Lelk0e/DA_Sensorbox/README.md

# DA_Sensorbox
Partnerfirma: b2-electronics
Teammitglieder: Mayer Phillip, Yilmaz Mert-Can, Schatzmann Alexander, Marte Linus
Software: Clockify, Github
