Lelk0e/DA_Sensorbox/Website/readme.txt

This website shows sensor data with the help of a graph. 
The graph can be filtered trough the comboboxes and then be applied trough the apply button. 

The guy, who made the whole programming in this website, is me, Mert, follow me on https://github.com 
under the name God (Mcy61).
