Lelk0e/DA_Sensorbox/Ilustrations/Mesh_Topologie.png

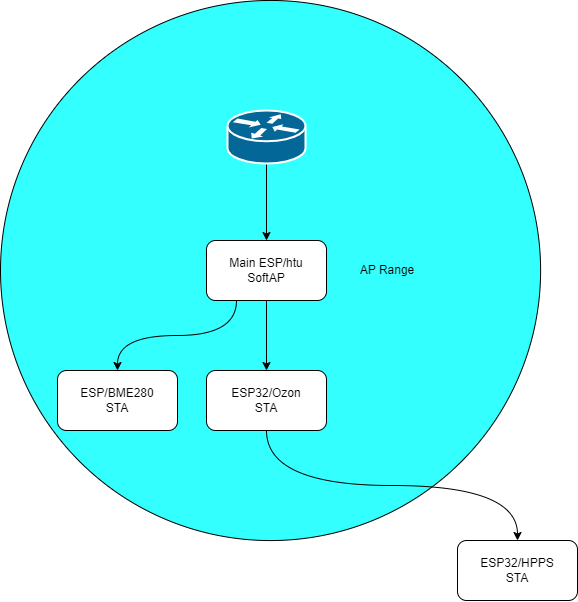
Ilustrations/Mesh_Topologie.png
