Lelk0e/DA_Sensorbox/Sensorbox_HW/Partlist/V2_Partlist_for_7_2_2025.xlsx

HW-SENSORBOX
Bauteilnamen | Werte | Datasheet | Footprint | Anzahl für 1 Sensorbox | Anzahl für 4 Sensorboxen | Bestellnummer | Besteller | Link
ADC1,GND1,SCL1,SDA/Signal1,VCC1 | Conn_01x01_Socket | ~ | Connector_PinHeader_2.00mm:PinHeader_1x01_P2.00mm_Vertical | 5 | 10 | BCS-105-L-S-TE | Mouser | https://www.mouser.at/ProductDetail/Samtec/BCS-105-L-S-TE?qs=0lQeLiL1qyaMkEiX4cl9NA%3D%3D
BT1 | BC3AAAPC |  | Battery_Basket:BatteryHolder_Keystone_2479_3xAAA | 1 | 10 | BC4AAAPC-ND | Digikey | https://www.digikey.com/en/products/detail/mpd-memory-protection-devices/bc4aaapc/2439255
C1,C2,C3,C4,C5,C7,C8,C9,C10,C11,C12,C13,CO4 | 100nF-50V | ~ | Capacitor_SMD:C_1206_3216Metric_Pad1.33x1.80mm_HandSolder | 13 | 130 | VJ1206Y104JXAAT | Mouser | https://www.mouser.at/ProductDetail/Vishay-Vitramon/VJ1206Y104JXAAT
C14 - GEPOLT | 100uF - 16V | ~ | Capacitor_SMD:CP_Elec_6.3x7.7 | 1 | 10 | AVS107M16E16T-F | Mouser | https://www.mouser.at/ProductDetail/Cornell-Dubilier-CDE/AVS107M16E16T-F?qs=7mAFCb0QvLHWeBEUpi7LdA%3D%3D
CO1,CO2 | 33uF - 16V | ~ | Capacitor_SMD:C_1812_4532Metric_Pad1.57x3.40mm_HandSolder | 2 | 20 | C4532X5R1C336M250KA | Mouser | https://www.mouser.at/ProductDetail/TDK/C4532X5R1C336M250KA
CR1220 | Battery | ~ | Battery:BatteryHolder_LINX_BAT-HLD-012-SMT | 1 | 10 | BAT-HLD-012-SMT | Mouser | https://eu.mouser.com/ProductDetail/TE-Connectivity-Linx-Technologies/BAT-HLD-012-SMT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
CT1 | 1500pF - 50V | ~ | Capacitor_SMD:C_1206_3216Metric_Pad1.33x1.80mm_HandSolder | 1 | 10 | VJ1206A152JXAMT | Mouser | https://www.mouser.at/ProductDetail/Vishay-Vitramon/VJ1206A152JXAMT?qs=yLK21R3P1nepmGezkusWog%3D%3D
D1 | 1N5819 | http://www.vishay.com/docs/88525/1n5817.pdf | Diode_SMD:D_SMB-SMC_Universal_Handsoldering | 1 | 10 | 1N5819HW-7-F | Mouser | https://www.mouser.at/ProductDetail/Diodes-Incorporated/1N5819HW-7-F?qs=NQ47qNm99eDyWTEd07miYA%3D%3D
D2,D4,D5,D7 | PESD3V3U1UA | https://www.vishay.com/docs/85751/1n4148ws.pdf | Diode_SMD:D_SOD-323 | 4 | 40 | PESD3V3U1UA,115 | Mouser | https://www.mouser.at/ProductDetail/Nexperia/PESD3V3U1UA115?qs=LOCUfHb8d9um8sDoel6KgQ%3D%3D
D3 | SMBJ5.0A | https://www.vishay.com/docs/88301/15ke.pdf | Diode_SMD:D_SMB_Handsoldering | 1 | 10 | SMBJ5.0A-E3/52 | Mouser | https://www.mouser.at/ProductDetail/Vishay-General-Semiconductor/SMBJ5.0A-E3-52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
F1 | Polyfuse_Small | ~ | Fuse:Fuse_Littelfuse_372_D8.50mm | 1 | 10 | LVR016K | Mouser | https://www.mouser.at/ProductDetail/Littelfuse/LVR016K?qs=sGAEpiMZZMt8Ji9PfVTQzN6NT3KHR8M0Bcdq0wgyxVc%3D
JP1 | Jumper_2_Bridged | ~ | Connector_PinHeader_2.54mm:PinHeader_1x02_P2.54mm_Vertical | 1 | 10 | 61300211121 | Mouser | https://www.mouser.at/ProductDetail/Wurth-Elektronik/61300211121?qs=t4813l51qx%252B1A5GYDQxPlw%3D%3D
L1 | 56ÂµH - 2.1A | ~ | Inductor_SMD:L_0805_2012Metric_Pad1.05x1.20mm_HandSolder | 1 | 10 | 744771156 | Mouser | https://www.mouser.at/ProductDetail/Wurth-Elektronik/744771156?qs=E%2F%2FhvbtCqpMc%2F29JH%252BKd8Q%3D%3D
MicroSD2,U7 | ~ |  | -- mixed values -- | 2 | 10 | 104031-0811 | Mouser | https://www.mouser.at/ProductDetail/Molex/104031-0811?qs=udsGRKD4nA3Tvy7wqky%252BuA%3D%3D
R1 | 10R | ~ | Resistor_SMD:R_1206_3216Metric_Pad1.30x1.75mm_HandSolder | 1 | 10 | TNPW120610R0BEEA | Mouser | https://www.mouser.at/ProductDetail/Vishay-Dale/TNPW120610R0BEEA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
R1_1,Rset1 | 10k | ~ | Resistor_SMD:R_1206_3216Metric_Pad1.30x1.75mm_HandSolder | 2 | 20 | RT1206FRE1310KL | Mouser | https://www.mouser.at/ProductDetail/YAGEO/RT1206FRE1310KL?qs=Fz%2FrpjPuTcG5N6QupHrVzw%3D%3D
R1_2 | 0R | ~ | Resistor_SMD:R_1206_3216Metric_Pad1.30x1.75mm_HandSolder | 1 | 10 | MCA12060Z0000ZP500 | Mouser | https://www.mouser.at/ProductDetail/Vishay-Beyschlag/MCA12060Z0000ZP500
R1_3 | 1.3 kR | ~ | Resistor_SMD:R_1206_3216Metric_Pad1.30x1.75mm_HandSolder | 1 | 10 | CRCW12061K30FKEAHP | Mouser | https://www.mouser.at/ProductDetail/Vishay-Dale/CRCW12061K30FKEAHP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
R1_4,R1_5 | 1kR | ~ | Resistor_SMD:R_1206_3216Metric_Pad1.30x1.75mm_HandSolder | 2 | 20 | ERA-8AEB102V | Mouser | https://www.mouser.at/ProductDetail/Panasonic/ERA-8AEB102V
R1_6,R2,R9,R10,R18,R19 | 10kR | ~ | Resistor_SMD:R_1206_3216Metric_Pad1.30x1.75mm_HandSolder | 6 | 60 | ERA-8VRB1002V | Mouser | https://www.mouser.at/ProductDetail/Panasonic/ERA-8VRB1002V
R1_7 | 2k2 | ~ | Resistor_SMD:R_1206_3216Metric_Pad1.30x1.75mm_HandSolder | 1 | 10 | ERJ-T08J222V | Mouser | https://www.mouser.at/ProductDetail/Panasonic/ERJ-T08J222V?qs=sGAEpiMZZMvdGkrng054tzSGWtpoOZZITsjqBumh3fU%3D
R2_1 | 6k8 | ~ | Resistor_SMD:R_1206_3216Metric_Pad1.30x1.75mm_HandSolder | 1 | 10 | MCA12060D6801BP500 | Mouser | https://www.mouser.at/ProductDetail/Vishay-Beyschlag/MCA12060D6801BP500
R3,R4 | 100R | ~ | Resistor_SMD:R_1206_3216Metric_Pad1.30x1.75mm_HandSolder | 2 | 20 | RT1206FRE13100RL | Mouser | https://www.mouser.at/ProductDetail/YAGEO/RT1206FRE13100RL?qs=1mbolxNpo8fXWimun2XthA%3D%3D
R5,R7,R8,R15 | 4.7k | ~ | Resistor_SMD:R_1206_3216Metric_Pad1.30x1.75mm_HandSolder | 4 | 40 | RT1206FRE074K7L | Mouser | https://www.mouser.at/ProductDetail/YAGEO/RT1206FRE074K7L?qs=yNCrj0CQcyLcoH%2FB%252BiP%2FFQ%3D%3D
R6 | 20kR | ~ | Resistor_SMD:R_1206_3216Metric_Pad1.30x1.75mm_HandSolder | 1 | 10 | ERA-8APB203V | Mouser | https://www.mouser.at/ProductDetail/Panasonic/ERA-8APB203V
R20,R21,R33 | 3k | ~ | Resistor_SMD:R_1206_3216Metric_Pad1.30x1.75mm_HandSolder | 3 | 30 | RT1206FRE073KL | Mouser | https://www.mouser.at/ProductDetail/YAGEO/RT1206FRE073KL?qs=yNCrj0CQcyKT5hyFvM%2FxIg%3D%3D
Rsc1 | 0R39 | ~ | Resistor_SMD:R_1206_3216Metric_Pad1.30x1.75mm_HandSolder | 1 | 10 | RCWE1206R390FKEA | Mouser | https://www.mouser.at/ProductDetail/Vishay-Dale/RCWE1206R390FKEA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
Rx1 | 180R | ~ | Resistor_SMD:R_1206_3216Metric_Pad1.30x1.75mm_HandSolder | 1 | 10 | TNPW1206180RBEEA | Mouser | https://www.mouser.at/ProductDetail/Vishay-Dale/TNPW1206180RBEEA
TH2 | Type K | https://www.heraeus.com/media/media/group/doc_group/products_1/hst/sot_to/de_15/to_92_d.pdf | Resistor_THT:R_Axial_DIN0204_L3.6mm_D1.6mm_P5.08mm_Horizontal | 0 | 0 | Type K, PTFE, 1m | x | x
TP1,TP2,TP3,TP4,TP5,TP6,TP7,TP10,TP11 | TestPoint | ~ | TestPoint:TestPoint_Loop_D1.80mm_Drill1.0mm_Beaded | 9 | 100 | SMC-1-01-1-GT | Digikey | https://www.digikey.com/en/products/detail/adam-tech/SMC-1-01-1-GT/9830404
U1 | BME280 | https://www.bosch-sensortec.com/media/boschsensortec/downloads/datasheets/bst-bme280-ds002.pdf | BME280 (2):BME280 | 0 | 0 | x | x | x
U2,U5,U13 | OPA197xD | http://www.ti.com/lit/ds/symlink/opa197.pdf | Package_SO:SOIC-8_3.9x4.9mm_P1.27mm | 3 | 30 | OPA197IDR | Mouser | https://www.mouser.at/ProductDetail/Texas-Instruments/OPA197IDR?qs=gMfM3zrbS4ovW9KDi3YhFw%3D%3D
U4 | MC33063AD | http://www.onsemi.com/pub_link/Collateral/MC34063A-D.PDF | Package_SO:SOIC-8_3.9x4.9mm_P1.27mm | 0 | 0 | x | x | x
U6 | MAX31855EASA | http://datasheets.maximintegrated.com/en/ds/MAX31855.pdf | Package_SO:SOIC-8_3.9x4.9mm_P1.27mm | 1 | 10 | MAX31855EASA+ | Mouser | https://www.mouser.at/ProductDetail/Analog-Devices-Maxim-Integrated/MAX31855EASA%2b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
U8 | HPP845E131R5 | HPP845E131R5 | HPP_footprints:SON6_HPP845E131R5_TEC | 0 | 0 | x | x | x
U11 | PS1-O3-100 | https://sgx.cdistore.com/datasheets/sgx/ds-0353-ps1ps4-o3-100.pdf | Ozonsensor:PS1O3100 | 0 | 0 | x | x | x
U12 | DS3231M | http://datasheets.maximintegrated.com/en/ds/DS3231.pdf | Package_SO:SOIC-16W_7.5x10.3mm_P1.27mm | 1 | 10 | DS3231M+ | Mouser | https://www.mouser.at/ProductDetail/Analog-Devices-Maxim-Integrated/DS3231M%2b?qs=Bakm8ERcljpd4MQpcnSykw%3D%3D
Jumper | x | x | x | 1 | 10 | M7686-05 | Mouser | https://www.mouser.at/ProductDetail/Harwin/M7686-05?qs=%252Bk6%2F5FB6qrn2j2nK8fZfOA%3D%3D
2x 19pin für esp | x | x | x | 2 | 20 | SSW-119-01-T-S | Mouser | https://www.mouser.at/ProductDetail/Samtec/SSW-119-01-T-S?qs=rU5fayqh%252BE1O7STzIZWpjA%3D%3D
5pin Stecker ex.Sensor | x | x | x | 1 | 10 | 61300511121 | Mouser | https://www.mouser.at/ProductDetail/Wurth-Elektronik/61300511121?qs=PhR8RmCirEZCsCRHq%252BvfRQ%3D%3D
2 pin Socket (für TypK-Sensor) | x | x | x | 1 | 10 | SMC-1-02-1-GT | Mouser | https://www.mouser.at/ProductDetail/Adam-Tech/SMC-1-02-1-GT?qs=HoCaDK9Nz5fkB9er4tyTzQ%3D%3D
CR1220 Batterie | x | https://www.mouser.at/datasheet/2/575/1/2684410000_BATTERY_CR1220_3V_en-3038809.pdf | x | 1 | 10 | 2684410000 | Mouser | https://www.mouser.at/ProductDetail/Weidmuller/2684410000?qs=QNEnbhJQKvb766Vpshc03A%3D%3D
