Lelk0e/DA_Sensorbox/docs/Zitate/How to Set an ESP32 Access Point (AP) for Web Server.md

https://randomnerdtutorials.com/esp32-access-point-ap-web-server/
--- 
creation date: 2024-09-30 16:28 
modification date: Monday 30th September 2024 16:28:57 
 << [[2024-09-29]] | [[2024-10-01]] >>
 ___
