Lelk0e/DA_Sensorbox/Website/bme_test_data.txt

Time:11:30:08:BME:-6.16
Time:11:30:38:BME:31.97
Time:11:31:08:BME:9.05
Time:11:31:38:BME:1.56
Time:11:32:08:BME:13.92
Time:11:32:38:BME:37.68
Time:11:33:08:BME:33.69
Time:11:33:38:BME:24.49
Time:11:34:08:BME:31.39
Time:11:34:38:BME:25.84
Time:11:35:08:BME:15.9
Time:11:35:38:BME:-8.05
Time:11:36:08:BME:0.58
Time:11:36:38:BME:29.17
Time:11:37:08:BME:39.38
Time:11:37:38:BME:13.2
Time:11:38:08:BME:22.78
Time:11:38:38:BME:-0.13
Time:11:39:08:BME:36.73
Time:11:39:38:BME:-0.84
Time:11:40:08:BME:11.67
Time:11:40:38:BME:38.87
Time:11:41:08:BME:28.73
Time:11:41:38:BME:38.58
Time:11:42:08:BME:-8.95
Time:11:42:38:BME:10.34
Time:11:43:08:BME:29.47
Time:11:43:38:BME:-2.81
Time:11:44:08:BME:22.15
Time:11:44:38:BME:25.21
Time:11:45:08:BME:7.74
Time:11:45:38:BME:16.08
Time:11:46:08:BME:-5.23
Time:11:46:38:BME:17.41
Time:11:47:08:BME:-3.66
Time:11:47:38:BME:34.61
Time:11:48:08:BME:18.48
Time:11:48:38:BME:-6.05
Time:11:49:08:BME:35.43
Time:11:49:38:BME:38.44
Time:11:50:08:BME:-1.57
Time:11:50:38:BME:19.93
Time:11:51:08:BME:20.14
Time:11:51:38:BME:-6.56
Time:11:52:08:BME:8.47
Time:11:52:38:BME:36.72
Time:11:53:08:BME:20.53
Time:11:53:38:BME:4.05
Time:11:54:08:BME:20.84
Time:11:54:38:BME:29.05
Time:11:55:08:BME:24.32
Time:11:55:38:BME:28.73
Time:11:56:08:BME:24.08
Time:11:56:38:BME:21.16
Time:11:57:08:BME:36.69
Time:11:57:38:BME:25.4
Time:11:58:08:BME:25.52
Time:11:58:38:BME:6.03
Time:11:59:08:BME:29.75
Time:11:59:38:BME:-3.06
Time:12:00:08:BME:19.16
Time:12:00:38:BME:16.07
Time:12:01:08:BME:14.53
Time:12:01:38:BME:24.58
Time:12:02:08:BME:-0.37
Time:12:02:38:BME:6.06
Time:12:03:08:BME:-3.31
Time:12:03:38:BME:4.62
Time:12:04:08:BME:-9.67
Time:12:04:38:BME:6.13
Time:12:05:08:BME:21.29
Time:12:05:38:BME:16.16
Time:12:06:08:BME:8.46
Time:12:06:38:BME:-1.27
Time:12:07:08:BME:10.0
Time:12:07:38:BME:-5.95
Time:12:08:08:BME:18.73
Time:12:08:38:BME:17.48
Time:12:09:08:BME:5.92
Time:12:09:38:BME:30.12
Time:12:10:08:BME:16.74
Time:12:10:38:BME:39.02
Time:12:11:08:BME:11.24
Time:12:11:38:BME:-3.48
Time:12:12:08:BME:19.44
Time:12:12:38:BME:35.31
Time:12:13:08:BME:13.81
Time:12:13:38:BME:10.18
Time:12:14:08:BME:28.26
Time:12:14:38:BME:17.36
Time:12:15:08:BME:2.21
Time:12:15:38:BME:12.95
Time:12:16:08:BME:30.81
Time:12:16:38:BME:-1.07
Time:12:17:08:BME:39.37
Time:12:17:38:BME:25.26
Time:12:18:08:BME:-9.11
Time:12:18:38:BME:-8.35
Time:12:19:08:BME:6.93
Time:12:19:38:BME:25.79
