Lelk0e/DA_Sensorbox/Sensorbox_HW/SensorBox/SensorBox.kicad_pcb

## KiCad design Sensorbox_HW/SensorBox/SensorBox.kicad_pcb (2025-06-12)

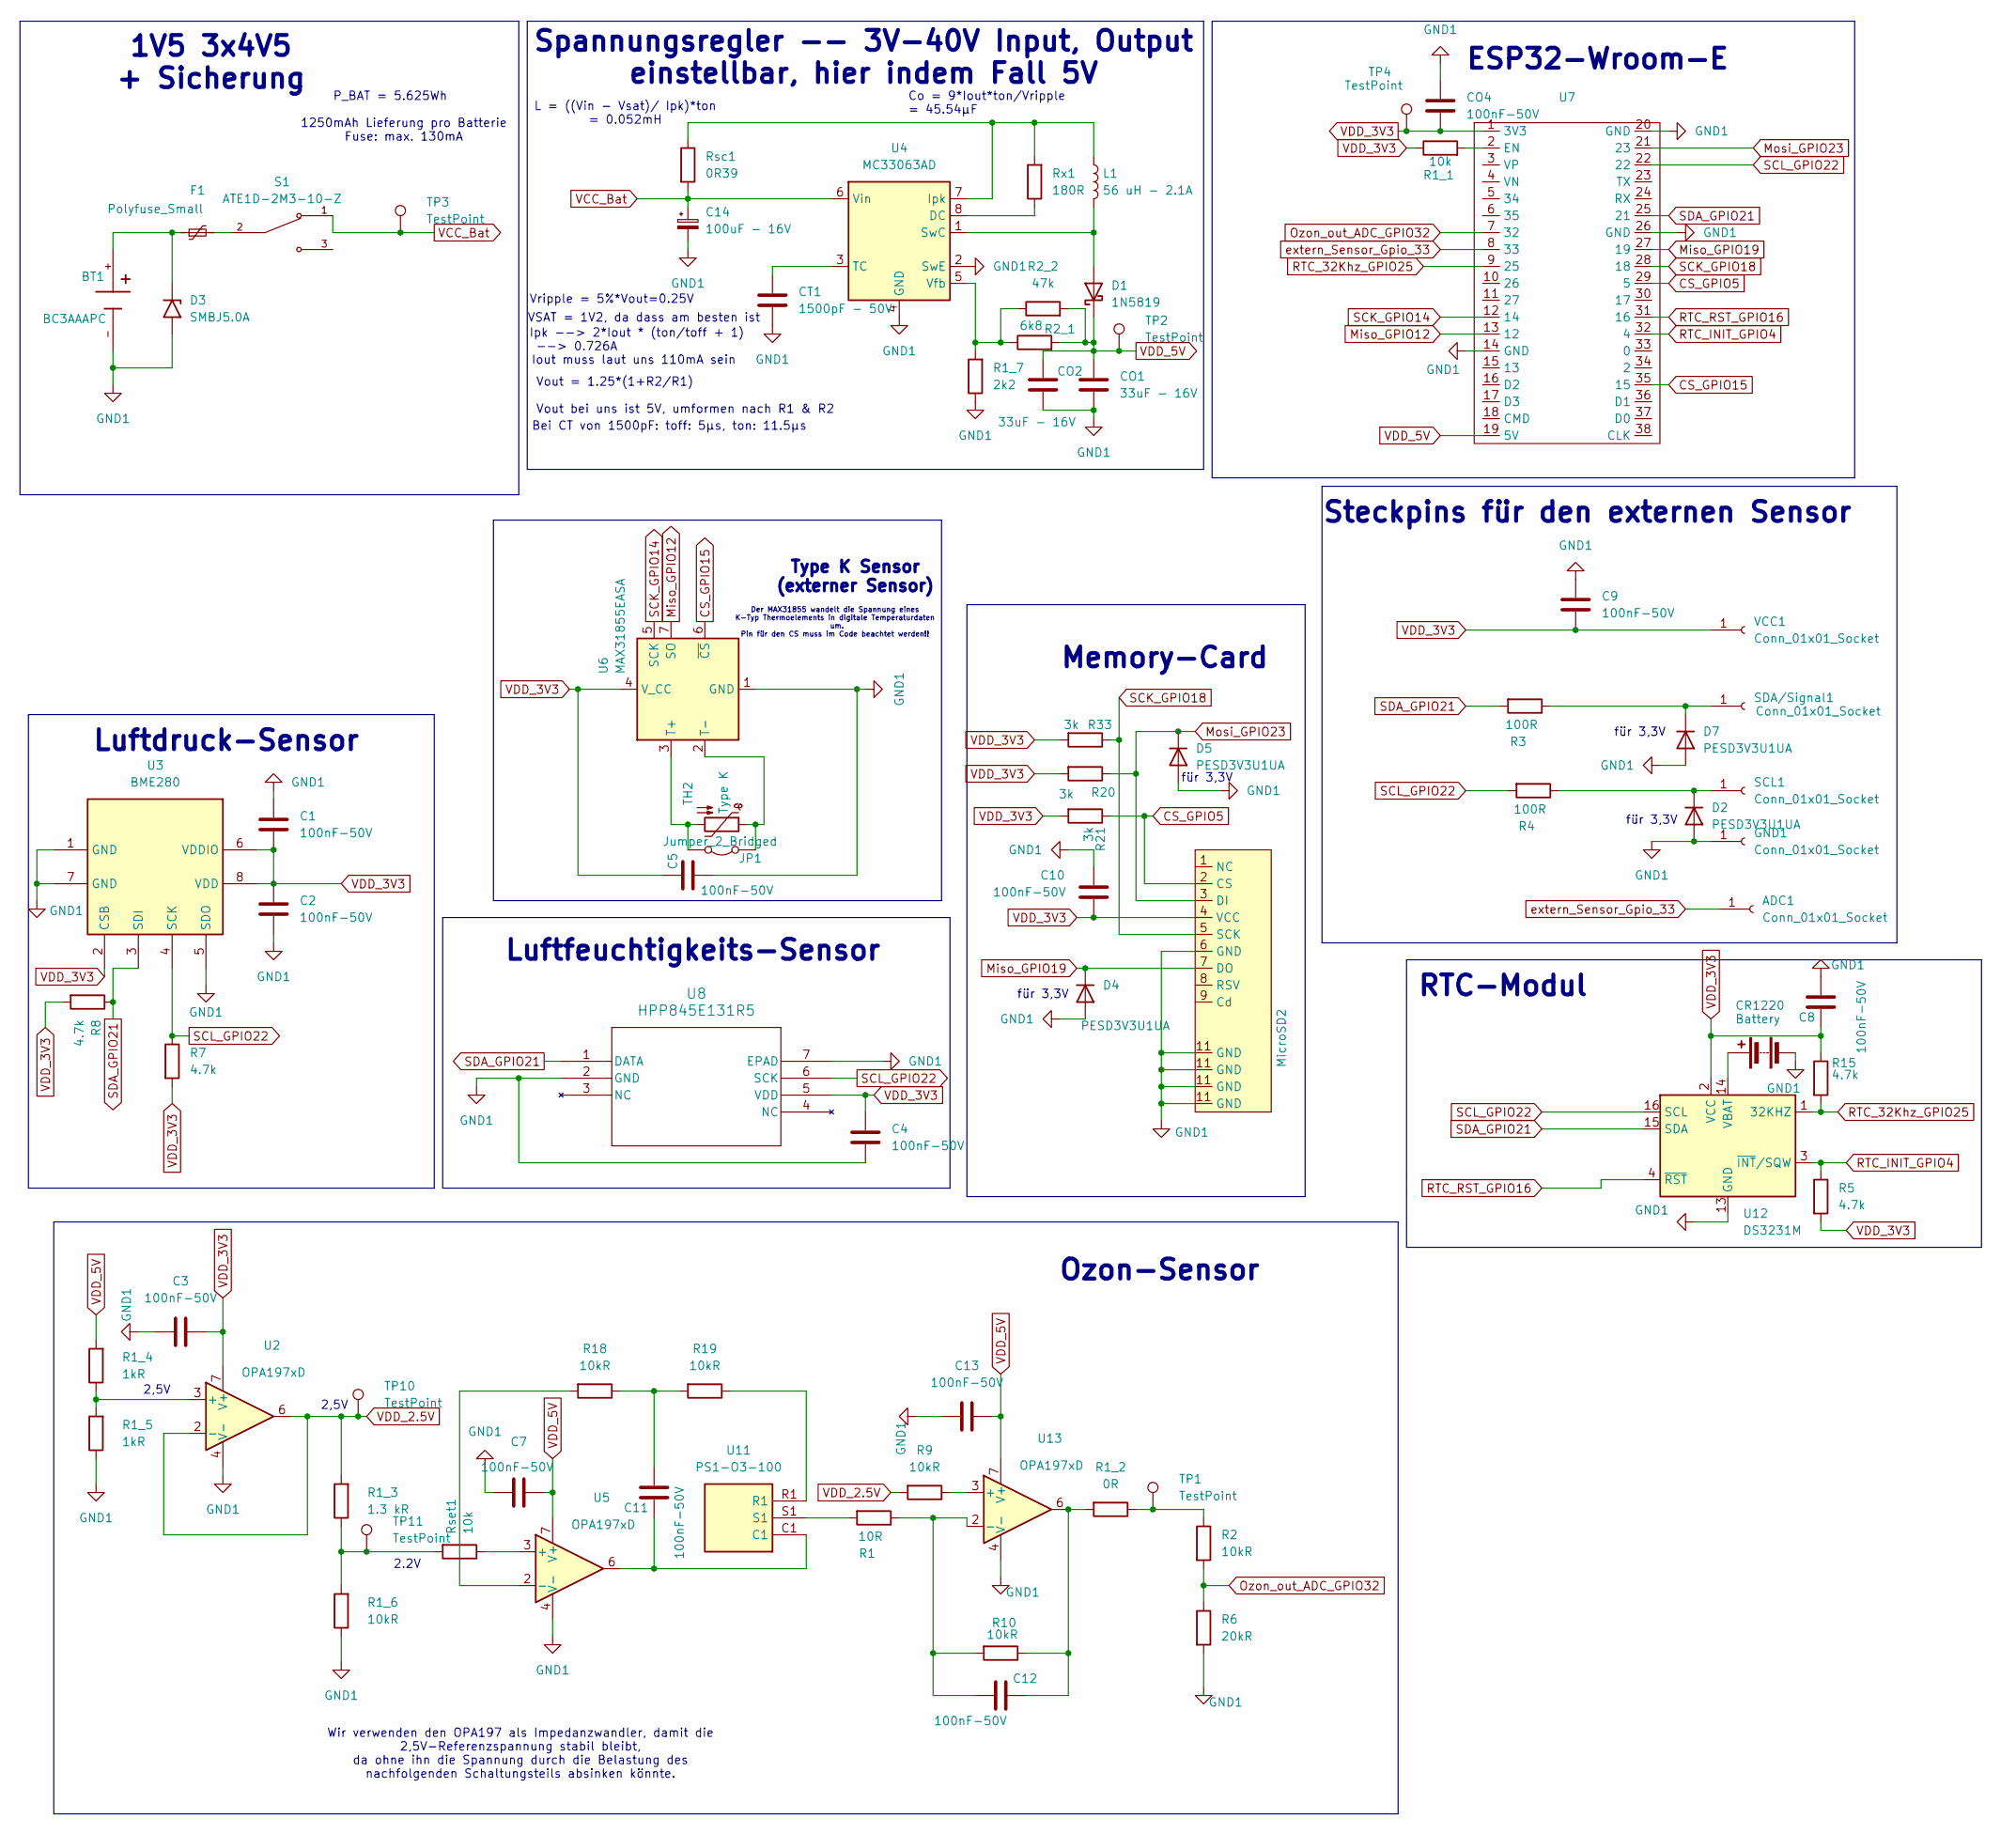
[picture p43: schematic SensorBox.kicad_sch]

Parts:
ADC1: Conn_01x01_Socket; PinHeader_1x01_P2.00mm_Vertical
BT1: BC3AAAPC; BatteryHolder_Keystone_2479_3xAAA; PARTREV J
C1, C2, C3, C4, C5, C7, C8, C9, C10, C11, C12, C13: 100nF-50V; C_1206_3216Metric_Pad1.33x1.80mm_HandSolder
C14: 100uF - 16V; CP_Elec_6.3x7.7
CO1, CO2: 33uF - 16V; C_1812_4532Metric_Pad1.57x3.40mm_HandSolder
CO4: 100nF-50V; C_1206_3216Metric_Pad1.33x1.80mm_HandSolder
CR1220: Battery; BatteryHolder_LINX_BAT-HLD-012-SMT
CT1: 1500pF - 50V; C_1206_3216Metric_Pad1.33x1.80mm_HandSolder
D1: 1N5819; D_SMB-SMC_Universal_Handsoldering
D2, D4, D5, D7: PESD3V3U1UA; D_SOD-323
D3: SMBJ5.0A; D_SMB_Handsoldering
F1: Polyfuse_Small; Fuse_Littelfuse_372_D8.50mm
GND1: Conn_01x01_Socket; PinHeader_1x01_P2.00mm_Vertical
JP1: Jumper_2_Bridged; PinHeader_1x02_P2.54mm_Vertical
L1: 56 uH - 2.1A; L1
MicroSD2: microSD_HC_Molex_104031-0811
R1: 10R; R_1206_3216Metric_Pad1.30x1.75mm_HandSolder
R1_1: 10k; R_1206_3216Metric_Pad1.30x1.75mm_HandSolder
R1_2: 0R; R_1206_3216Metric_Pad1.30x1.75mm_HandSolder
R1_3: 1.3 kR; R_1206_3216Metric_Pad1.30x1.75mm_HandSolder
R1_4, R1_5: 1kR; R_1206_3216Metric_Pad1.30x1.75mm_HandSolder
R1_6, R2, R9, R10, R18, R19: 10kR; R_1206_3216Metric_Pad1.30x1.75mm_HandSolder
R1_7: 2k2; R_1206_3216Metric_Pad1.30x1.75mm_HandSolder
R2_1: 6k8; R_1206_3216Metric_Pad1.30x1.75mm_HandSolder
R2_2: 47k; R_1206_3216Metric_Pad1.30x1.75mm_HandSolder
R3, R4: 100R; R_1206_3216Metric_Pad1.30x1.75mm_HandSolder
R5, R7, R8, R15: 4.7k; R_1206_3216Metric_Pad1.30x1.75mm_HandSolder
R6: 20kR; R_1206_3216Metric_Pad1.30x1.75mm_HandSolder
R20, R21, R33: 3k; R_1206_3216Metric_Pad1.30x1.75mm_HandSolder
Rsc1: 0R39; R_1206_3216Metric_Pad1.30x1.75mm_HandSolder
Rset1: 10k; R_1206_3216Metric_Pad1.30x1.75mm_HandSolder
Rx1: 180R; R_1206_3216Metric_Pad1.30x1.75mm_HandSolder
S1: ATE1D-2M3-10-Z; SW_ATE1D-2M3-10-Z
SCL1: Conn_01x01_Socket; PinHeader_1x01_P2.00mm_Vertical
SDA/Signal1: Conn_01x01_Socket; PinHeader_1x01_P2.00mm_Vertical
TH2: Type K; R_Axial_DIN0204_L3.6mm_D1.6mm_P5.08mm_Horizontal
TP1, TP2, TP3, TP4, TP10, TP11: TestPoint; TestPoint_Loop_D1.80mm_Drill1.0mm_Beaded
U2, U5, U13: OPA197xD; SOIC-8_3.9x4.9mm_P1.27mm
U3: BME280; Bosch_LGA-8_2.5x2.5mm_P0.65mm_ClockwisePinNumbering_ch
U4: MC33063AD; SOIC-8_3.9x4.9mm_P1.27mm
U6: MAX31855EASA; SOIC-8_3.9x4.9mm_P1.27mm
U7: ESP32_Wroom_E
U8: HPP845E131R5; SON6_HPP845E131R5_TEC
U11: PS1-O3-100; PS1O3100; Manufacturer_Part_Number PS1-O3-100
U12: DS3231M; SOIC-16W_7.5x10.3mm_P1.27mm
VCC1: Conn_01x01_Socket; PinHeader_1x01_P2.00mm_Vertical

Connections:
CS_GPIO5: MicroSD2.2 (CS), R21.1, U7.29 (5)
CS_GPIO15: U6.6 (~CS), U7.35 (15)
GND1: BT1.-, C1.1, C2.1, C3.2, C4.2, C5.2, C7.2, C8.2, C9.2, C10.2, C13.2, C14.2, CO1.2, CO2.2, CO4.1, CR1220.2 (-), CT1.2, D2.2 (A), D3.2 (A2), D4.2 (A), D5.2 (A), D7.2 (A), GND1.1, MicroSD2.6 (GND), MicroSD2.11 (GND), R1_5.1, R1_6.1, R1_7.1, R6.2, U2.4 (V-), U3.1 (GND), U3.5 (SDO), U3.7 (GND), U4.2 (SwE), U4.4 (GND), U5.4 (V-), U6.1 (GND), U7.14 (GND), U7.20 (GND), U7.26 (GND), U8.2 (GND), U8.7 (EPAD), U12.5 (GND), U12.6 (GND), U12.7 (GND), U12.8 (GND), U12.9 (GND), U12.10 (GND), U12.11 (GND), U12.12 (GND), U12.13 (GND), U13.4 (V-)
Miso_GPIO12: U6.7 (SO), U7.13 (12)
Miso_GPIO19: D4.1 (K), MicroSD2.7 (DO), U7.27 (19)
Mosi_GPIO23: D5.1 (K), MicroSD2.3 (DI), R20.1, U7.21 (23)
unnamed: C11.1, U5.6, U11.C1
unnamed: C11.2, R18.1, R19.2
unnamed: C12.2, R1_2.2, R10.1, U13.6
unnamed: CR1220.1 (+), U12.14 (VBAT)
unnamed: D1.2 (A), L1.2, U4.1 (SwC)
unnamed: D2.1 (K), R4.1, SCL1.1
unnamed: BT1.+, D3.1 (A1), F1.1
unnamed: D7.1 (K), R3.1, SDA/Signal1.1
unnamed: F1.2, S1.2
unnamed: JP1.1 (A), TH2.1, U6.2 (T-)
unnamed: JP1.2 (B), TH2.2, U6.3 (T+)
unnamed: R1.2, U11.S1
unnamed: R1_2.1, R2.1, TP1.1
unnamed: R1_3.1, R1_6.2, Rset1.2, TP11.1
unnamed: R19.1, U11.R1
unnamed: R1_4.1, R1_5.2, U2.3 (+)
unnamed: Rx1.1, U4.8 (DC)
unnamed: L1.1, Rsc1.1, Rx1.2, U4.7 (Ipk)
unnamed: CT1.1, U4.3 (TC)
unnamed: R1_7.2, R2_1.1, R2_2.1, U4.5 (Vfb)
unnamed: Rset1.1, U5.3 (+)
unnamed: R18.2, U5.2 (-)
unnamed: R1_1.2, U7.2 (EN)
unnamed: R9.1, U13.3 (+)
unnamed: C12.1, R1.1, R10.2, U13.2 (-)
Ozon_out_ADC_GPIO32: R2.2, R6.1, U7.7 (32)
RTC_32Khz_GPIO25: R15.2, U7.9 (25), U12.1 (32KHZ)
RTC_INIT_GPIO4: R5.1, U7.32 (4), U12.3 (~INT/SQW)
RTC_RST_GPIO16: U7.31 (16), U12.4 (~RST)
SCK_GPIO14: U6.5 (SCK), U7.12 (14)
SCK_GPIO18: MicroSD2.5 (SCK), R33.1, U7.28 (18)
SCL_GPIO22: R4.2, R7.1, U3.4 (SCK), U7.22, U8.6 (SCK), U12.16 (SCL)
SDA_GPIO21: R3.2, R8.1, U3.3 (SDI), U7.25 (21), U8.1 (DATA), U12.15 (SDA)
VCC_Bat: C14.1, Rsc1.2, S1.1, TP3.1, U4.6 (Vin)
VDD_2.5V: R1_3.2, R9.2, TP10.1, U2.2 (-), U2.6
VDD_3V3: C1.2, C2.2, C3.1, C4.1, C5.1, C8.1, C9.1, C10.1, CO4.2, MicroSD2.4 (VCC), R1_1.1, R5.2, R7.2, R8.2, R15.1, R20.2, R21.2, R33.2, TP4.1, U2.7 (V+), U3.2 (CSB), U3.6 (VDDIO), U3.8 (VDD), U6.4 (V_CC), U7.1 (3V3), U8.5 (VDD), U12.2 (VCC), VCC1.1
VDD_5V: C7.1, C13.1, CO1.1, CO2.1, D1.1 (K), R1_4.2, R2_1.2, R2_2.2, TP2.1, U5.7 (V+), U7.19 (5V), U13.7 (V+)
extern_Sensor_Gpio_33: ADC1.1, U7.8 (33)

Notes on the sheet:
für 3,3V
Luftdruck-Sensor
Vripple = 5%*Vout=0.25V
Spannungsregler -- 3V-40V Input, Output einstellbar, hier indem Fall 5V
Luftfeuchtigkeits-Sensor
Ipk --> 2*Iout * (ton/toff + 1) --> 0.726A
Type K Sensor (externer Sensor)
Steckpins für den externen Sensor
1V5 3x4V5 + Sicherung
Memory-Card
Bei CT von 1500pF: toff: 5µs, ton: 11.5µs
Iout muss laut uns 110mA sein
ESP32-Wroom-E
Der MAX31855 wandelt die Spannung eines K-Typ Thermoelements in digitale Temperaturdaten um. Pin für den CS muss im Code beachtet werden!!
RTC-Modul
Wir verwenden den OPA197 als Impedanzwandler, damit die 2,5V-Referenzspannung stabil bleibt, da ohne ihn die Spannung durch die Belastung des nachfolgenden Schaltungsteils absinken könnte.
VSAT = 1V2, da dass am besten ist
1250mAh Lieferung pro Batterie Fuse: max. 130mA
Co = 9*Iout*ton/Vripple = 45.54µF
Vout = 1.25*(1+R2/R1) Vout bei uns ist 5V, umformen nach R1 & R2
P_BAT = 5.625Wh
L = ((Vin - Vsat)/ Ipk)*ton = 0.052mH
2,5V
Ozon-Sensor
2.2V

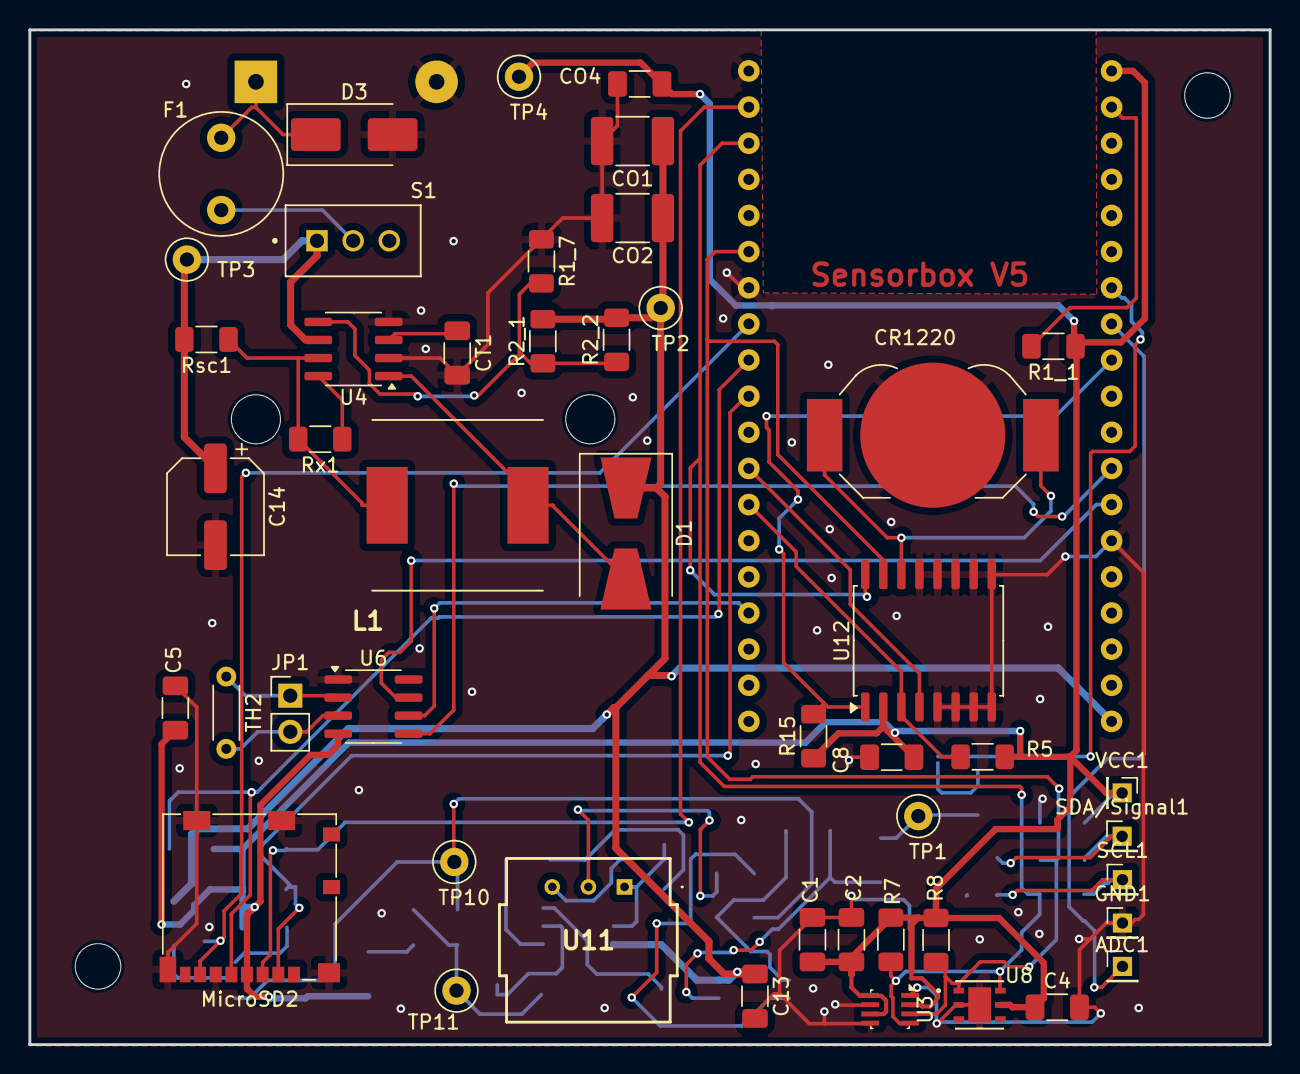
[picture p44: board SensorBox.kicad_pcb from above]

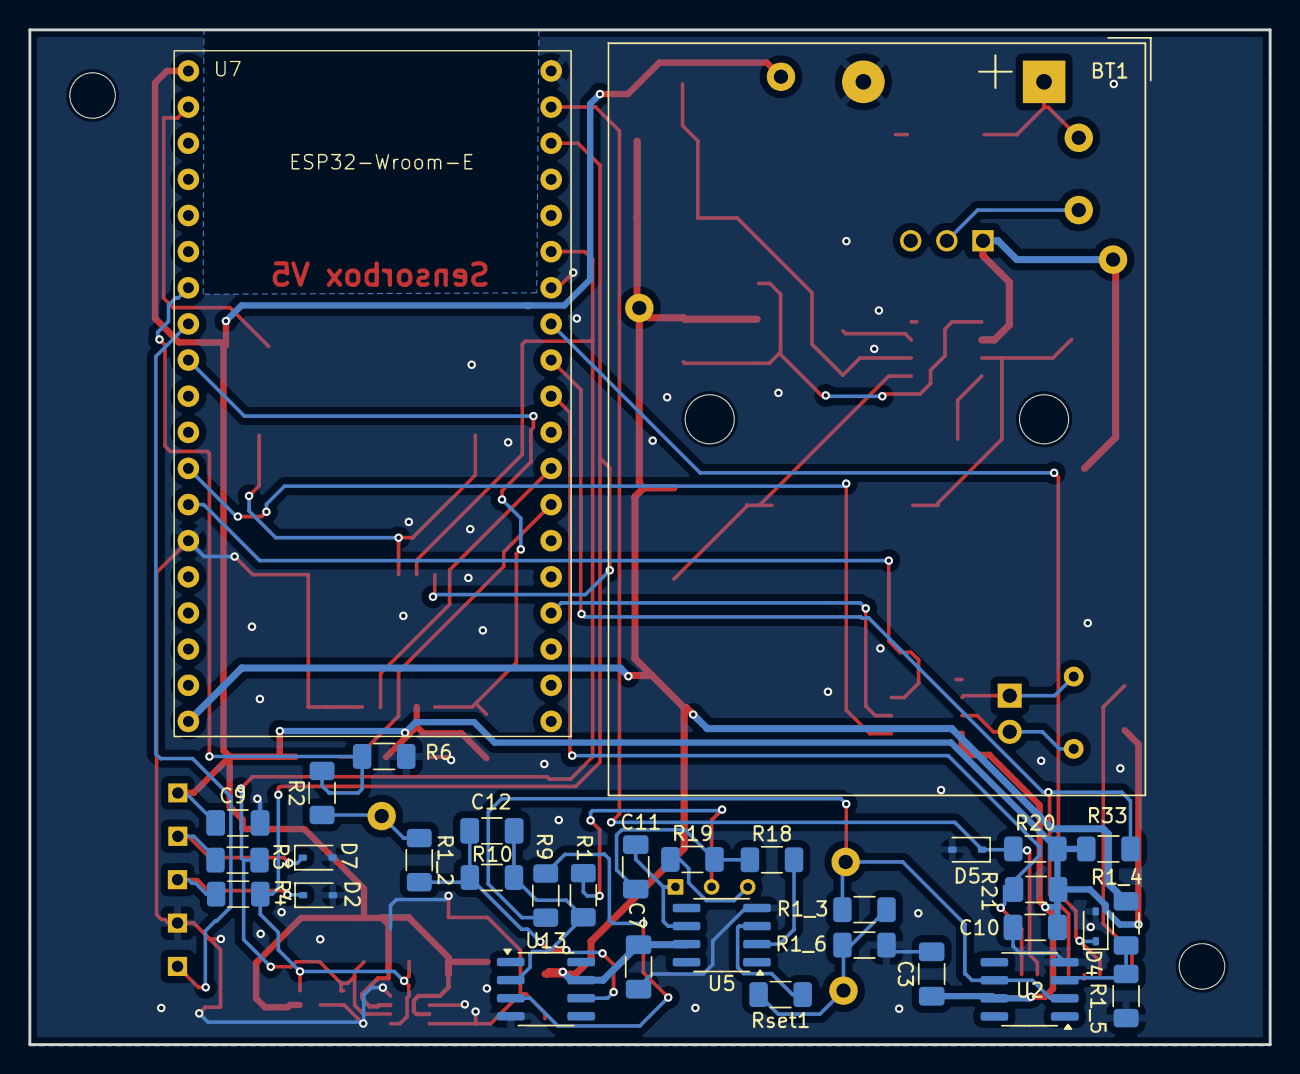
[picture p45: board SensorBox.kicad_pcb from below]

Board: 2 copper layers, 87.2 x 71.3 mm, 80 parts (33 on the bottom side), 44 nets.
