Lelk0e/DA_Sensorbox/Sensorbox_HW/Versionen/V2_16_12_2024/SensorBox/SensorBox.kicad_sch

## KiCad design Sensorbox_HW/Versionen/V2_16_12_2024/SensorBox/SensorBox.kicad_sch (2025-03-31)

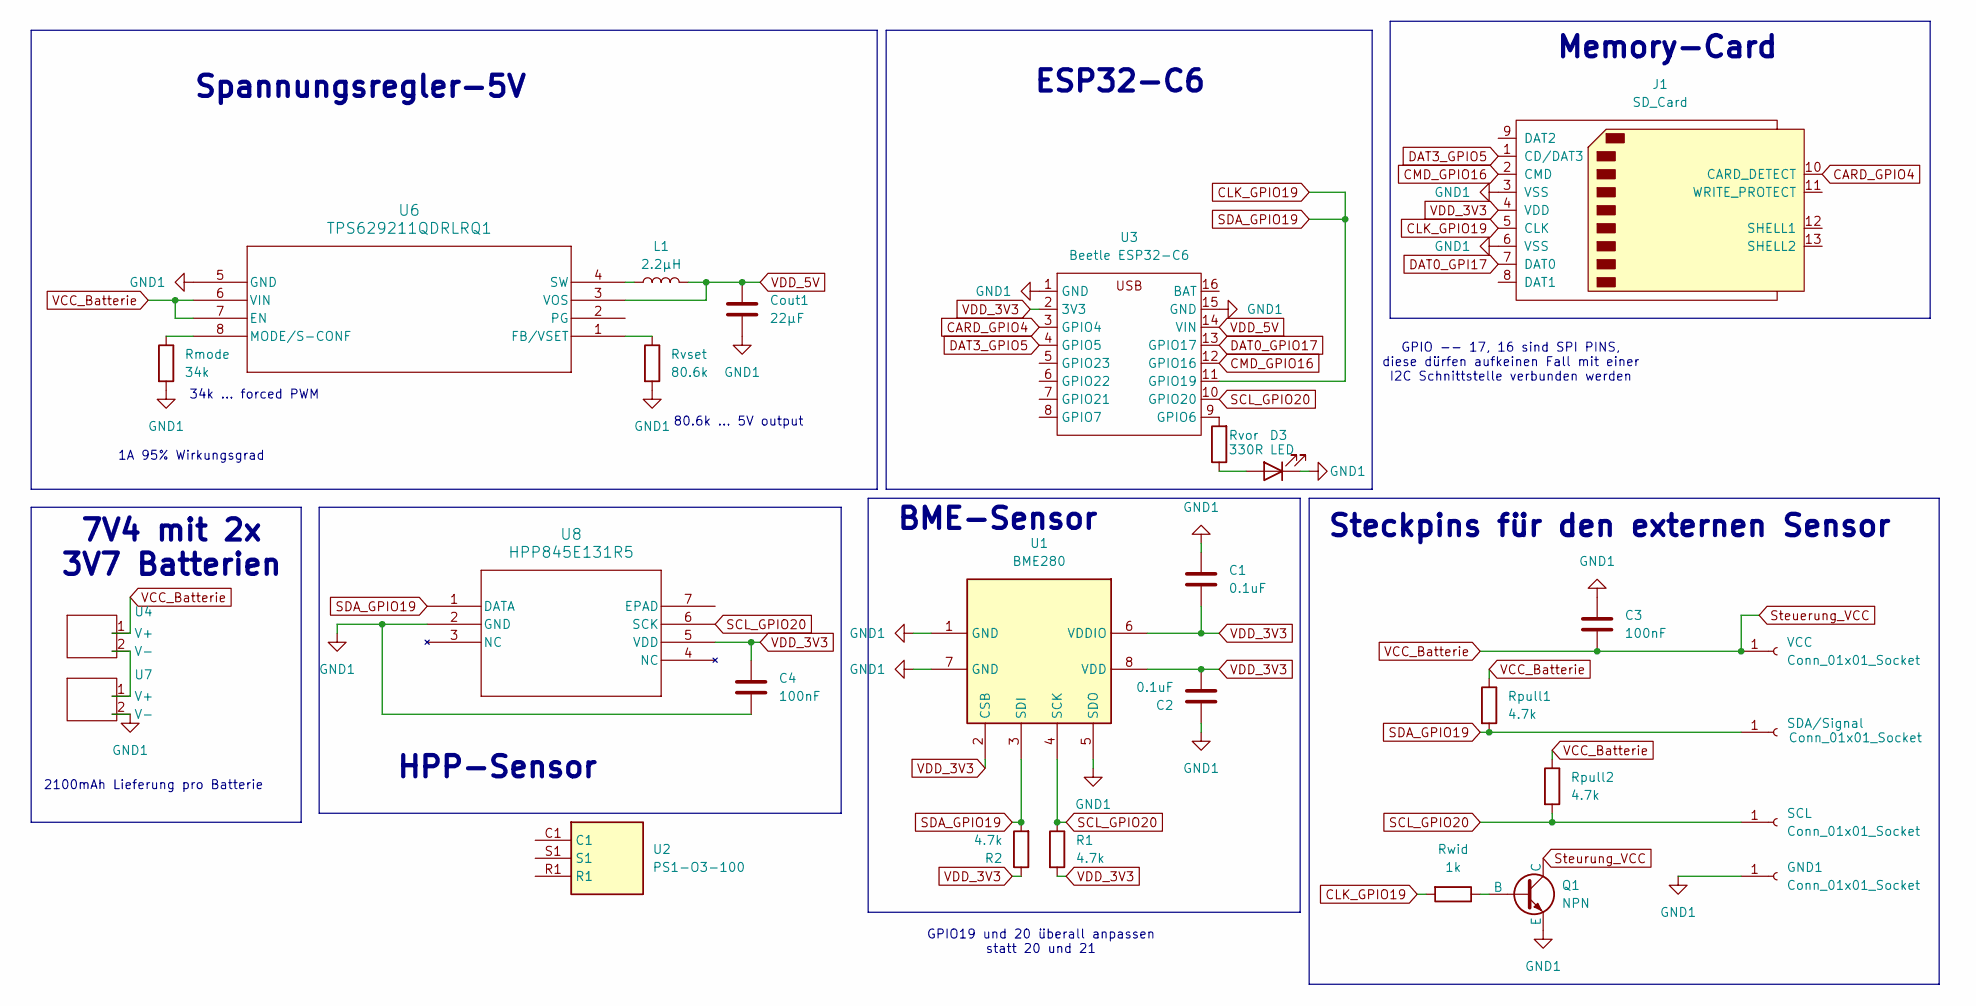
[picture p46: schematic SensorBox.kicad_sch]

Parts:
C1, C2: 0.1uF; C_0402_1005Metric_Pad0.74x0.62mm_HandSolder
C3, C4: 100nF; C_0402_1005Metric_Pad0.74x0.62mm_HandSolder
Cout1: 22µF; C_0402_1005Metric_Pad0.74x0.62mm_HandSolder
D3: LED; LED_0402_1005Metric
GND1: Conn_01x01_Socket; PinHeader_1x01_P2.00mm_Vertical
J1: SD_Card
L1: 2.2µH; L_0402_1005Metric_Pad0.77x0.64mm_HandSolder
Q1: NPN
R1, R2: 4.7k; R_0402_1005Metric
Rmode: 34k; R_0402_1005Metric
Rpull1, Rpull2: 4.7k; R_0402_1005Metric
Rvor: 330R; R_0402_1005Metric
Rvset: 80.6k; R_0402_1005Metric
Rwid: 1k; R_0402_1005Metric
SCL: Conn_01x01_Socket; PinHeader_1x01_P2.00mm_Vertical
SDA/Signal: Conn_01x01_Socket; PinHeader_1x01_P2.00mm_Vertical
U1: BME280; Bosch_LGA-8_2.5x2.5mm_P0.65mm_ClockwisePinNumbering
U2: PS1-O3-100; PS1O3100; Manufacturer_Part_Number PS1-O3-100
U3: Beetle ESP32-C6
U4, U7: Bat_3V7
U6: TPS629211QDRLRQ1; SOT5X3_DRL_TEX
U8: HPP845E131R5; SON6_HPP845E131R5_TEC
VCC: Conn_01x01_Socket; PinHeader_1x01_P2.00mm_Vertical

Connections:
CARD_GPIO4: J1.10 (CARD_DETECT), U3.3 (GPIO4)
CLK_GPIO19: J1.5 (CLK), R2.2, Rpull1.2, Rwid.2, SDA/Signal.1, U1.3 (SDI), U3.11 (GPIO19), U8.1 (DATA)
CMD_GPIO16: J1.2 (CMD), U3.12 (GPIO16)
DAT0_GPI17: J1.7 (DAT0)
DAT0_GPIO17: U3.13 (GPIO17)
DAT3_GPIO5: J1.1 (CD/DAT3), U3.4 (GPIO5)
GND1: C1.2, C2.2, C3.2, C4.2, Cout1.2, D3.1 (K), GND1.1, J1.3 (VSS), J1.6 (VSS), Q1.3 (E), Rmode.2, Rvset.2, U1.1 (GND), U1.5 (SDO), U1.7 (GND), U3.1 (GND), U3.15 (GND), U6.5 (GND), U7.2 (V-), U8.2 (GND)
unnamed: D3.2 (A), Rvor.1
unnamed: L1.1, U6.4 (SW)
unnamed: Q1.2 (B), Rwid.1
unnamed: Rmode.1, U6.8 (MODE/S-CONF)
unnamed: Rvor.2, U3.9 (GPIO6)
unnamed: Rvset.1, U6.1 (FB/VSET)
unnamed: U4.2 (V-), U7.1 (V+)
SCL_GPIO20: R1.1, Rpull2.2, SCL.1, U1.4 (SCK), U3.10 (GPIO20), U8.6 (SCK)
Steuerung_VCC: C3.1, Rpull1.1, Rpull2.1, U4.1 (V+), U6.6 (VIN), U6.7 (EN), VCC.1
Steurung_VCC: Q1.1 (C)
VDD_3V3: C1.1, C2.1, C4.1, J1.4 (VDD), R1.2, R2.1, U1.2 (CSB), U1.6 (VDDIO), U1.8 (VDD), U3.2 (3V3), U8.5 (VDD)
VDD_5V: Cout1.1, L1.2, U3.14 (VIN), U6.3 (VOS)

Notes on the sheet:
34k ... forced PWM
Spannungsregler-5V
7V4 mit 2x 3V7 Batterien
BME-Sensor
Memory-Card
ESP32-C6
Steckpins für den externen Sensor
2100mAh Lieferung pro Batterie
HPP-Sensor
1A 95% Wirkungsgrad
GPIO19 und 20 überall anpassen statt 20 und 21
80.6k ... 5V output
GPIO -- 17, 16 sind SPI PINS, diese dürfen aufkeinen Fall mit einer I2C Schnittstelle verbunden werden
