Lelk0e/DA_Sensorbox/Code/Code_testing/PainlessMesh_Master/PainlessMesh_Master.ino

#include <Wire.h>
#include "painlessMesh.h"

#define MESH_PREFIX "Sensorbox"
#define MESH_PASSWORD "12345678"
#define MESH_PORT 5555

painlessMesh mesh;
Scheduler userScheduler;
String message = "";
uint32_t nodeID;

void sendMessage();
Task taskSendMessage(TASK_SECOND * 1, TASK_FOREVER, &sendMessage);
void sendMessage() {
  String msg = "Hello from node ";
  msg += mesh.getNodeId();
  mesh.sendBroadcast(msg);

  taskSendMessage.setInterval(random(TASK_SECOND * 1, TASK_SECOND * 5));
}

// Needed for painlessMesh library
void receivedCallback(uint32_t from, String &msg) {
  Serial.printf("startHere: Received from %u msg=%s\n", from, msg.c_str());
  message = msg.c_str();
  nodeID = from;
}

void newConnectionCallback(uint32_t nodeId) {
  Serial.printf("--> startHere: New Connection, nodeId = %u\n", nodeId);
}

void changedConnectionCallback() {
  Serial.printf("Changed connections\n");
}

void nodeTimeAdjustedCallback(int32_t offset) {
  Serial.printf("Adjusted time %u. Offset = %d\n", mesh.getNodeTime(), offset);
}

void setup() {
  Serial.begin(115200);

  //mesh.setRoot(true);
  mesh.setDebugMsgTypes(ERROR | STARTUP);

  mesh.init(MESH_PREFIX, MESH_PASSWORD, &userScheduler, MESH_PORT);
  mesh.onReceive(&receivedCallback);
  mesh.onNewConnection(&newConnectionCallback);
  mesh.onChangedConnections(&changedConnectionCallback);
  mesh.onNodeTimeAdjusted(&nodeTimeAdjustedCallback);

  userScheduler.addTask(taskSendMessage);
  taskSendMessage.enable();
}

void loop() {
  mesh.update();
}
