Lelk0e/DA_Sensorbox/(commit log)

2024-07-20 Update Lastenheft Sensorbox_2024.07.01.docx
2024-09-16 Pflichtenheft Überarbeitung
    Wir haben das Pflichtenheft mit den besprochenen Punkten der Firma überarbeitet und erweitert
2024-09-23 Pflichtenheft Bearbeitung
    Bearbeitung vom 22.09.2024 hochgeladen. Welcher, die entgültige Version vom Pflichtenheft sein sollte
2024-09-23 ESP32-Wroom-32e Datasheet push
2024-09-30 Pflichtenheft - finale
    Sensoren automatisch erkennen - als Wunsch
    - 100h Netzgebunden - unnötig
    - 5 min aus und dann 2 min messen - unvorteilhaft
    - keine MainBox
    - gleicher Schaltplan für alle Boxen
    - Prototyp kann alles draufhaben
    - Peripherer ist falsch - keine direkte Verbindung auf dem Schaltplan
    - EMMC für SD-Karte
    - Sensoren heraussuchen und Daten aufschreiben
    - WLAN viel Strom - Zigbee besser??
    - wenn PC angeschlossen ist dann kein sleepmodus bzw. senden über WLAN
    - C/C++ anstatt Micropython
    - Aufpassen weil Batterie Spannung sinkt --> Spannungswandler
    - loram???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
2024-09-30 Sensorik
    4 sensoren
2024-09-30 Zitate
    Code Beispiele für WLAN Verbindung mit ESP32-Wroom-32e als Access-Point und Station
2024-10-07 Sensorik_final
    bearbeitet und finalisiert
2024-10-14 Update Sensoren_final.docx
    final bearbeitung
2024-10-21 Schaltplan_Sensorbox
    Projekt für den Schaltplan erstellen
    [SensorBox.kicad_pcb, SensorBox.kicad_sch]
2024-10-21 Sensorauswahl
    Sensoren auswahl
2024-10-21 Schaltpläne
    Einzelne Schaltpläne (Layouts) eingefügt
    [Luftdruck_Sensor.kicad_sch, Luftfeuchtigkeit_Sensor.kicad_sch, Ozon_Sensor.kicad_sch, SensorBox.kicad_sch, Temp_Sensor.kicad_sch]
2024-10-21 Sch.
    Schaltplan und footprints für BME280, Luftfeuchtigkeitssensor fürs Projekt eingefügt. Mit Plattform IO abgecheckt, ob die Libraries für Arduino Framework passen --> Sie passen.
    [SensorBox.kicad_pcb]
2024-10-21 schalt
    fehler bei sch. dateien --> versucht zu fixen
    [Ozon_Sensor.kicad_sch]
2024-10-30 big change - hardware
    folders changed, new proj. assigned
    [Luftdruck_Sensor.kicad_sch, Luftdruck_sensor.kicad_pcb, Luftdruck_sensor.kicad_sch, Luftfeuchtigkeit_Sensor.kicad_sch, Luftfeuchtigkeit_sensor.kicad_pcb, Luftfeuchtigkeit_sensor.kicad_sch, Ozon_Sensor.kicad_sch, Ozon_sensor.kicad_pcb]
2024-10-30 folders changed in sensorbox_schaltplan
    [Luftdruck_sensor.kicad_pcb, Luftdruck_sensor.kicad_sch, Luftfeuchtigkeit_sensor.kicad_pcb, Luftfeuchtigkeit_sensor.kicad_sch, Ozon_sensor.kicad_pcb, Ozon_sensor.kicad_sch, PT100_sensor.kicad_pcb, PT100_sensor.kicad_sch]
2024-10-30 name changed of sensorbox
    [Luftdruck_sensor.kicad_pcb, Luftdruck_sensor.kicad_sch, Luftfeuchtigkeit_sensor.kicad_pcb, Luftfeuchtigkeit_sensor.kicad_sch, Ozon_sensor.kicad_pcb, Ozon_sensor.kicad_sch, PT100_sensor.kicad_pcb, PT100_sensor.kicad_sch]
2024-10-30 sch. neben sensoren
    pins rausgesucht
    [Luftdruck_sensor.kicad_sch]
2024-10-31 Hauptschaltung
    Sensorbox, erste Hauptschaltung realisiert --> ESP32 C6 selbst designt und eingebaut und die restlichen Funktionen eingebaut --> SD Karte mit ESP verbunden, Spannungsregler eingebaut für die Spannung vom ESP
    [SensorBox.kicad_sch]
2024-11-01 version abgespeichert von der ersten revision
2024-11-01 Main Sensor-Schaltung Revision 2
    [SensorBox.kicad_sch]
2024-11-04 Änderung_schematic
    Luftfeuchtigkeitssensor bearbeitet
    [SensorBox.kicad_sch]
2024-11-18 schaltplan änderungen
    spannungswandler und pins geändert
    [Luftdruck_sensor.kicad_pcb, Luftdruck_sensor.kicad_sch, Luftfeuchtigkeit_sensor.kicad_pcb, Luftfeuchtigkeit_sensor.kicad_sch, Ozon_sensor.kicad_pcb, Ozon_sensor.kicad_sch, PT100_sensor.kicad_pcb, PT100_sensor.kicad_sch]
2024-11-25 Create ESP32_BME280_WIFI_AP.ino
    read data from BME280-sparkfun and send it over a WIFI access-point
2024-12-02 Testing sending data from multiple sensors with a wifi sleep
2024-12-08 Update SensorBox.kicad_sch
    pin Belegungen geändert, bzw. angepasst zum Messaufbau. Speziell GPIO20, 19
    [SensorBox.kicad_sch]
2024-12-11 Mesh Topology, measure power consumption
    Wir haben uns die Mesh Topologie vertieft angeschaut, wobei wir uns gedacht haben zuerst eine kurze Verbindung zum Router zu erstellen um eine API anfrage für den Referenzdruck rauszusenden. Weiter haben wir versucht die Größe der Batterie durch Messung des Stromverbrauchs zu messen. Dazu haben wir mit einem ESP ein AP erzeugt und an einen anderen Daten gesendet.
2024-12-13 code
    änderung
    [SensorBox.kicad_sch]
2024-12-14 Schaltplan
    Schematic changed, fixes to hpp sensor and to the convertor. In addition changes to voltage supply
    [ExternerSensor.kicad_sch, SensorBox.kicad_sch]
2024-12-14 Externer Sensor
    aufgebaut
    [ExternerSensor.kicad_sch]
2024-12-26 Batterie und Regler
    eingestellt und berechnet
    [SensorBox.kicad_sch]
2024-12-27 V3-Sensorbox
    Externer sensor Type K geändert und Fuse/Sicherheitsschalter eingefügt
    [SensorBox.kicad_sch]
2024-12-27 änderungen
    50h gecheckt, bme angepasst
    bme und hpp beschriftet
    Eingang und Ausgang leitungen angepasst nach draußen oder nach innen
    [SensorBox.kicad_sch]
2024-12-27 Create PainlessMesh_Master.ino
    Erstellung des Meshnet anhand der PainlessMesh library für root und weitere nodes
2024-12-28 Lib
    library erschaffen bezüglich dem sd modul zum ablesen und schreiben
    plus im hauptschaltplan eingesetzt
    [SensorBox.kicad_sch]
2024-12-28 Test
    .
    [SensorBox.kicad_sch]
2024-12-28 Create SD-Card_Master.ino
    Code für das Lesen und Schreiben auf eine SD-Karte. Ungeprüft, da das Modul kaputt ist und somit nicht funktioniert hat. Steckverbindung und SD-Karte sind auf Fehler geprüft worden und nichts wurde gefunden
2024-12-28 Erweiterung V3
    Library für den ESP32 Wroom E erstellt, die Verbindungen ausgetauscht vom C6 zum neuen ESP und die SD Karte verbunden
    [SensorBox.kicad_sch]
2024-12-28 .
    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
    [SensorBox.kicad_sch]
2024-12-28 Asynchrones Hosting recherche
    Research associated to asynchrony hosting
    --> what is it? how does it work? what is the difference between synchrony hosting?
    In addition there are several applications, which can run on this format.
    On the other hand, most of the asyn. programs are in C written and the http environment is implemented with js.
    My Opinion:
    The implementation of the asyn. programs is quite difficult and complex, but will be further analyzed. A few general aspects of asyn. is already known and the base function of it, is also not so complicated. So considering these points, it is definitely possible to implement in our environment.
    [ExternerSensor.kicad_pcb, ExternerSensor.kicad_sch]
2024-12-29 namedMesh erstellt
    Main und Client side für das Meshnet erstellt so das es autonom zu einer Kommunikation zwischen den ESP´s führt. Der code stellt eine Verbindung zwischen allen ESP´s dar und der mainESP teilt daraufhin seine NodeID und seinen nodeName, was es den restlichen, nicht root ESP´s erlaubt zu wissen an welchen ESP sie ihre Daten senden müssen
2024-12-29 SensorboxV3
    Ozonsensor eingebaut mit schaltung, Inverter Eingebaut für Ozonsensor-Schaltung
    [SensorBox.kicad_sch]
2024-12-29 Asyn_hosting
    First i deleted the 2 libraries, because copy-right etc.
    Then i made a project under arduiono ide with a readme.txt
    👽
    The readme.txt contains the licences of the libraries i used
    The main code "async" contains only a base structur, which methods, which will be modified in the future.
    But in addition the string_data, which will contain all information about the sensors, was divided in 4 sections "4 sensors data". With that method the graphical way of the website, will be much smoother and easier to implement.
    Ofc, some code parts were not known, so i searched those in the internet and looked up some tutorials. On zotero you can see my search history.
2024-12-30 async Webserver erstellt
    Ich habe einen Asynchronen Webserver erstellt der es ermöglichen soll eine Webpage zu hosten die, die Sensordaten darstellt
2024-12-30 changes
    i made a test program if we check the time with js and give it back to the esp.
    for that i used Date, which works with the UTC time zone. The time zone is displayed on a label, which updates with every event or http request.
    The html only shows the hpp sensor data. In addition this only raw code, meaning i was not able to test it. Mayer has to test via his esp, to see if he can really extract the date, which should work, but we'll see.
    Further more a added a folder named, Website_html_js --> this will be the actual website, which will be modified.
2024-12-30 Revert "changes"
    This reverts commit 985babfc8de051d71098531e7ef970764ba211a7.
    [asyn_hosting.ino]
2024-12-30 Reapply "changes"
    This reverts commit 0e96efdf2a7157f686607355d6fde5a1e36c4d99.
    [asyn_hosting.ino]
2025-01-01 changes
    first i changed a few folder names, cause they were not appropriate.
    then i started with the website (i also changed the location of the folder, it's important yk), for the website i started changing the html (the important looking part), added a css, js file.
    The js file has already his functions (but empty), the css is almost empty. But the base design of the html is finished. There were a few problems with stroke-width, cause its not working, idk why, it should work, but its not, nothing to horrible to worry about, but it still annoys me.
    So in summarize the html is almost finished, and tomorrow i will set my sights to the js.file and implement the xy graph on the canvas.
    [ExternerSensor.kicad_pcb, ExternerSensor.kicad_sch, SensorBox.kicad_pcb, SensorBox.kicad_sch]
2025-01-01 changes code
    First I i added a graph. This graph (x,y) will show the sensor data. This was accomplished with the LineTo, where I could draw Lines, to create a graph.
    In addition I added a read method for the comboxes. Where the program can get the actual value of the comboxes. It is very important later, for the graph.
    Further more, i could not found a method for the border, i think that it is not possible to set borders for a canvas. That are my thoughts.
2025-01-02 RTC-Modul einbauen
    Das RTC Modul eingebaut und die doku geschrieben
    [SensorBox.kicad_sch]
2025-01-02 Timestamps vom Webserver erhalten
    Ich habe den code für den Webserver so erweitert, dass es möglich ist timestamps, zur Verwaltung der Daten, zu erhalten . Dieses Feature ist besonders wichtig für die Anzeige der Daten
2025-01-02 html canvas (graph) x axe changes
    i updated the graph today. There are several changes. First there is a reset command for the graph, so the graph can have a reset, when the function (e.g. canvas_setting()) is being applied. But it deletes a few lines, this problem will be fixed tomorrow.
    Further more, the time zones were set, meaning, the graph can set his x axe to hours, days. This means our graph can show the user pieces of information of our sensor from a whole year.
2025-01-03 changes: canvas x axe bugs fixed and naming of the x axe
    First I fixed the problems we had till now, the first one was the clearing method. It cleared way too much or way too less. The fixation was --> changing the coordinates for the method. That was all, what was needed to fix the bug. The coordinates had to be changed, to the line width, in our case it, our line width was 2, so i had to change the method ctx.clearRect(x,1,x,x) to that. And of course i had to do it again, for width/height.
    Then I added the naming of the x axe. At first it was problematic to add a text in a canvas, because I never did that in js. But after i managed to add it, we could show the timelines, with the correct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
2025-01-04 Update namedMesh_AsyncWebserver_filesystem.ino
    Den Webserver erweitert mit dem Filesystem und den Code besser Lesbar zu machen
2025-01-09 Überarbeitung V3
    V3- Sensorbox laut Punkten von Joseph überarbeitet (Firma)
    [SensorBox.kicad_sch]
2025-01-11 Sensorbox V3
    RTC-Modul selber gebaut, Micro-SD-Karte gebaut, Alles angeordnet, Pullup-Widerstände hinzugefügt
    [SensorBox.kicad_sch]
2025-01-13 create client side
    Ich habe begonnen an der Client side des Meshnet zu arbeiten
2025-01-13 Überarbeitung Sensorbox V3
    Sicherheitsschaltung eingebaut, ESP anschauen warum getauscht, Email geschrieben
    [SensorBox.kicad_sch]
2025-01-16 Client side Weitergearbeitet
    Delimiter split eingebaut und code erweitert
2025-01-16 Überarbeitung V3
    Besprechung mit B2 und einige Dinge Überarbeitet (Fuse, SD Card usw.)
    [ExternerSensor.kicad_pcb, ExternerSensor.kicad_sch, SensorBox.kicad_pcb, SensorBox.kicad_sch]
2025-01-16 Besprechung B2
    Sicherung noch zu Datenleitungen dazu gehängt
    [SensorBox.kicad_sch]
2025-01-20 test
    test
    [SensorBox.kicad_sch]
2025-01-25 Präsentation
    Präsentation
    [SensorBox.kicad_pcb, SensorBox.kicad_sch]
2025-01-27 Update namedMesh_client_BME280.ino
    Updated Zeit Verwaltung und Nachrichten Typen unterscheiden
2025-02-03 SensorboxV4
    Fertigstellen
    [SensorBox.kicad_sch]
2025-02-03 changes hw
    problems with sch.
    [ExternerSensor.kicad_pcb, ExternerSensor.kicad_sch, SensorBox.kicad_sch]
2025-02-03 added sqlite database
    verwendung von sqlite micro logger library um die erhaltenen Daten des Sensors zusammen mit dem Timestamp in einer nicht nur leicht zugänglichen sondern auch gut lesbaren Art zu speichern
2025-02-03 PCB
    Footprints zuweisen
    [SensorBox.kicad_pcb, SensorBox.kicad_sch]
2025-02-05 created low power mode and added isConnected to namedMesh
2025-02-05 Sensorbox
    Layout erstellt
    [SensorBox.kicad_pcb]
2025-02-05 Layout fertiggestellt
    Layout überarbeitet und fertig gestellt
    [SensorBox.kicad_pcb, SensorBox.kicad_sch]
2025-02-06 Layout fertigstellen
    Löcher, Text auf platine
    [SensorBox.kicad_pcb]
2025-02-07 Besprechung
    Besprechung B2 Layout
    [SensorBox.kicad_sch]
2025-02-07 PCB überarbeitung
    [SensorBox.kicad_pcb, SensorBox.kicad_sch]
2025-02-09 updated low power mode and sendDB, added datasplit to mainESP and dataLogging
    Der Low Power Mode wurde so überarbeitet dass er vom mainESP initialisiert wird um synchronisierung gewährleisten. Des weiteren wurde die Datenverarbeitung über sqlite zum mainESP zugefügt und dass Daten-Management erweitert. Veraltete Methoden für den Webserver wurden entfernt
2025-02-10 changes Version 4
    Version 4 gespeichert bezüglich der HW, deshalb sind da auch so viele changes sichtbar.
    [SensorBox.kicad_pcb, SensorBox.kicad_sch]
2025-02-10 expanded low power mode, error correction, added ssl not working yet
    Low Power Mode so ausgearbeitet dass er nur durch ein Signal von der MainBox eingeschaltet werden kann. Des weiteren wurde der Server mit https erweitert was bis jetzt noch nicht fehlerfrei funktioniert.
    [namedMesh_AsyncWebserver_filesystem.ino, namedMesh_client_BME280.ino]
2025-02-10 HW bestellung
    Die Stückliste wurde geschrieben und gleichzeitig der Firma mitgeteilt.
    Die Stückliste ist in Sensorbox_HW gespeichert worden (in einem speziellen Ordner)
    [Partlist_for_7_2_2025.xlsx, SensorBox.kicad_sch]
2025-02-11 finished LPM, added writing DB data to webserver
    Der LPM wurde fertiggestellt so dass er synchron mit den anderen ESP´s funktioniert. Eine Methode zum senden der Daten an den Webserver wurde erstellt. LPM wird mit dem Taskscheduler gehandelt für synchrone Ausführung.
2025-02-11 ordner verschoben
    Es wurden ordner verschoben, da diese unsere Ordner Struktur unleserlich gemacht haben.
    [ExternerSensor.kicad_pcb, ExternerSensor.kicad_sch, SensorBox.kicad_pcb, SensorBox.kicad_sch]
2025-02-11 fetch data vom BME
    Es wurde versucht mithilfe einer asyn. fetch methode, Daten abzulesen (in dem Format, was gewollt war), die Methode wurde so geschrieben, dass diese wiederum für die anderen Sensoren benutzt werden kann, testweise ist es jetzt nur beim bme, aber später wird dieses in HTTP_get implementiert. Dies wurde noch nicht getestet, geplannt wäre es morgen, diese methode zu testen und mögliche bugs/fehler zu fixen.
2025-02-12 Stückliste überbearbeitet
    Die Stückliste hatte noch ein paar Fehler, z.B. gewisse Baubelegungen waren nicht passend oder sollten persönlich von Mouser sein. Die Excel-Liste wurde auch übersichtlicher gestaltet, da sehr viele Daten dort dargestellt werden.
    Zusätzlich wurde die davorige Version abgespeichert.
    [V1_Partlist_for_7_2_2025.xlsx, V2_Partlist_for_7_2_2025.xlsx]
2025-02-12 Stückliste nochmal überbearbeitet
    Da die Stückliste noch ein paar fehlerhafte Batterie Typen hatte (CR1220), hab diesen nochmal gefixt. Dazu hat ein Link nicht richtig funktioniert, dieser wurde ebenfalls gefixt.
    [V2_Partlist_for_7_2_2025.xlsx]
2025-02-15 website test program für das Senden von Daten
    Es wurde eine asynchrone Verbindung aufgestellt mit Codezeilen, die von unserem Projekt kommen. Dies wurde noch nicht getestet, morgen wird es getestet und überprüft ob diese Daten bei der Website ankommen.
2025-02-16 fixed errors in sqlite and in initializing
    sqlite hat standard c File-Operations benutzt anstatt von der SD-Karte. PinOut hat sich geändert
    [namedMesh_client_BME280.ino]
2025-02-16 Layout verschönern
    Leiterbahnen biem BME verschönert
    [SensorBox.kicad_pcb]
2025-02-16 Doku V3
    Die Dokumentation bezüglich der 3.Version von der Hardware wurde geschrieben.
    [SensorBox.kicad_sch]
2025-02-17 changed sqlite to work with sd card
    Die Methoden wurden so überarbeitet dass sie mit der SD Karte arbeiten anstatt nur zu File zu appenden
2025-02-17 Layout, Schaltplan, Doku
    Footprint von L1 abgeändert, Doku weitergearbeitet
    [SensorBox.kicad_pcb, SensorBox.kicad_sch]
2025-02-18 switched to PlatformIO, fixed declaration Errors
    Es wurde entschieden auf PlatformIO zu wechseln, da die Compile Zeit dort deutlich schneller ist als Arduino IDE. Aufgrund des Wechsel mussten noch einige declaration errors gefixt werden da die Entwicklungsumgebungen den Code anders Compilen
    [main.cpp, namedMesh.h]
2025-02-21 Changes Website and test sending
    Die Zeitanzeige der Website wurde geändert --> Jahresanzeigen oder Monatsanzeigen wurden als unnötig bewertet. Stattdessen wurden 1h, 2Tage und 2Wochen Ansicht eingebaut.
    Um diesen Code zu testen, wurde eine Extension in VsCode gefunden, welcher die Codezeilen viel simpler macht, als wenn man es in Arduino schreiben würde. Diese Extension ist wichtig, damit man die Datenübertragung testen kann, ob die gesendeten Werte bei der Website empfangen werden können.
    [V2_Partlist_for_7_2_2025.xlsx]
2025-02-21 added dns
    Ein DNS server wurde eingefügt um die Website via Sensorbox.com erreichbar zu machen.
2025-02-23 fixed and updated logging
    Die logging Funktion wurde so angepasst das sie auch mitten in der Messung abgebrochen werden kann und auch wieder zurückgesetzt werden kann.
    [main.cpp]
2025-02-24 SparkFunBME280 Library change
    settings.I2CAddress = 0x76; //We assume user has set the I2C address using setI2CAddress()
    Diese Code Zeile muss eingefügt werden, da die Default Adresse bei der Testung nicht funktioniert hat.
2025-02-25 website testing request data
    Der xy.http basierend mit Localhost wurden die Daten zur Website geschickt.
2025-02-26 Reworked SQlite in MainESP for better Timestamping
    Jahr, Monat und Tag hinzugefügt um Timestamps zu verbessern. SQlite so überarbeitet das die Datei nicht corrupted --> Datei muss Finalized werden. Code verschönert --> Übersicht
    [main.cpp]
2025-02-28 Wiederstand bei Spannungsregler dazugeschalten
    Parallel zu R2_1
    [SensorBox.kicad_sch]
2025-02-28 Zip Datei für Testversion erstellt
    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
    [SensorBox.kicad_pcb, SensorBox.kicad_sch]
2025-02-28 Finales Layout angefangen
    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
    [SensorBox.kicad_pcb, SensorBox.kicad_sch]
2025-03-01 Daten von BME mithilfe von einem WebServer erhalten
    Der Code wurde mithilfe eines XAAMP Webservers getestet. Die Time and data des bme, wurden erfolgreich angezeigt. Zusätzlich wurde statt, \n für die Sende-Datan, @ benutzt, da es einfacher ist, diesen zu splitten.
2025-03-02 Layout neue Version fertiggestellt
    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
    [SensorBox.kicad_pcb]
2025-03-02 added RTC function, reworked timestamp handling and reworked sendDB
    RTC Funktionen zum Code zugefügt aus der RTCLib von Adafruit. Timestamps so überarbeitet das sie mit dem RTC funktionieren. sendDB so überarbeitet das es nur die neuste Nachricht nach dem Timestamp ausgerichtet schickt
    [main.cpp]
2025-03-03 fix potential errors of data conflict, added HTU sensor
    Funktionen umgeschrieben um potentielle NULL Fehler zu vermeiden. HTU21 Sensor manuell hinzugefügt aufgrund fehlendes PlatformIO Supports. Datenbank Funktionen für den Sensor hinzugefügt
    [main.cpp]
2025-03-04 website anpassen gemäß ESP
    Beim Code wurde die fetch adresse des bmes gemäß esp32 angepasst.
    Zusätzlich wurde ein on/off button implementiert, für den Start und Stop der Messung.
2025-03-04 added debugging methods
    try catch und ähnliches zur Fehlersuche hinzugefügt
2025-03-04 fetchuserinfo änderungen
    Der Code wurde allgemein dargestellt und leserlicher hingeschrieben.
    Zusätzlich, können jetzt die anderen Sensoren die Methode benutzen.
2025-03-05 added error proofing and updated sqlite values
    Mehrere Try Catch und ähnliches zur Fehlersicherung hinzugefügt und Sqlite Werte über beide Dateien überarbeitet
    [main.cpp]
2025-03-06 Layout
    Layout komplett neugemacht (Sensoren usw. besser platziert.)
    [SensorBox.kicad_pcb, SensorBox.kicad_sch]
2025-03-06 added download over webserver
    Eine Möglichkeit beliebige Dateien über den Webserver herunterzuladen hinzugefügt und den Code übersichtlicher Formatiert.
2025-03-06 Schalter2-Änderungen
    Schalter zwischen 2 GPIOs hinzugefügt
    [SensorBox.kicad_pcb, SensorBox.kicad_sch]
2025-03-08 fixed guru meditation error and added more error proofing
    Der Guru Meditation error kam von der Fehlerhaften Inkludierung von AdafruitBusIO in der HTU Bibliothek anstatt in der .ini File was interne Library Fehler verursacht hat. Ein null pointer error war der Grund der Aufgrund der Fehlenden Library für den RTC war, da die Library nur für den HTU Sensor galt.
    [main.cpp]
2025-03-08 Visualierung der Daten (BME-Daten)
    BME-Daten konnten erfolgreich dargestellt werden. Dabei wurden die Testdaten mehrmals umgeschrieben, um unpassende Werte, die kleiner als z.B. 300hPa sind zu eliminieren.
2025-03-10 added typK sensor
    Den typk Sensor hinzugefügt und globale Pins defined. gemessene Werte plausibel.
2025-03-10 Ozon Pin zum ESP geändert
    [SensorBox.kicad_sch]
2025-03-10 Schalter zwischen GPIOS entfernt
    [SensorBox.kicad_sch]
2025-03-11 neue Test-Daten
    Die anderen Test-Daten von ozon, hpp und temp wurden geschrieben. Der Code zum lesen und zum Darstellen idieser Daten ist ähnlich wie der von dem BME.
2025-03-11 Testdaten getestet und auf Fehler überprüft.
2025-03-13 updated sensor data handling
    Die restlichen Sensoren hinzugefügt
2025-03-13 Graph Darstellung
    Bug Fixung des Graphen. Ozon-y-achse darstellung gemacht.
2025-03-14 aktuelle zeitangaben fix gefunden
    Das Problem war, dass die Feldvariablen nicht ordnungsgemäß gespeichert wurden.
2025-03-14 Zeitdarstellung [stunden] bei den aktuellen simulierten Messdaten
    Die Zeitstellung basiert derzeit auf Stunden und wird noch als [min] dargestellt. Zusätzlich ist die Genauigkeit dieser Darstellung ziemlich genau und weicht garnicht von den Messdaten ab.
    Der Bug, der gefixt wurde, war, dass bei der for-loop, double Werte benutzt wurden, wegen dem, wurden die Daten auch unvollständig dargestellt.
2025-03-16 Viele Änderungen bei der Darstellung
    - Unnötige Daten, wie 3h Anzeige wurde entfernt.
    - Temperatur-Aktuell Anzeige wurde erfolgreich programmiert und getestet
    - Die anderen Sensor-Daten wurden auch erfolgreich programmiert, müssen jedoch noch gründlich getestet werden.
    - Der Code wurde fehlersicherer gebaut, mit mehreren if-Anweisungen, etc.
2025-03-16 Änderungen Website (Kommentare, Funktionen)
    - Viele Kommentare wurden ergänzt oder schöner hingeschrieben, bzw. klarer formuliert.
    - Es wurde merhmals der Code gecheckt, ob dieser auch passt.
    - Zusätzlich wurde die Genauigkeit bei ein paar Sensor-Daten erhöht, wie z.B. vom Hpp, Ozon, Temp. Jedoch wurde dies beim BME vernachlässigt, da, gewisse Zahlen aufeinmal falsch zusammengezählt wurden.
2025-03-17 added live data transmission
    Daten werden jetzt live auf die Website gestreamt
2025-03-17 fetch_All_data inkludiert
    Diese Methode liest nur die ganzen Daten ab.
2025-03-22 added unique name over mac and added css and js loading
    Jeder ESP, außer der MainESP hat jetzt einen einzigartigen Namen über die Mac-Adresse
2025-03-31 änderung schaltplan (Anordnung)
    [SensorBox.kicad_sch]
2025-04-19 Websocket Funktionen implementiert
    Die mac Addressen wurden zu der mac-combobox hinzugefügt und die real-life daten sollten je nach mac-addresse beim Graph dargestellt werden. Dies wurde noch nicht getestet.
2025-06-07 PCB: BME PAD länger designed und Befestigungslöcher hinzugefügt
    [SensorBox.kicad_pcb, SensorBox.kicad_sch]
2025-06-12 HW-PCB-Change
    Die HW wurde angepasst --> Leiterbahnen wurden abgecheckt und geändert; PCB vom BME geändert; GND-Flächen angepasst
    [SensorBox.kicad_pcb, SensorBox.kicad_sch]
2025-06-28 Changed code to improve webserver stability
    Switched to a different approach, mesh pauses if client is connected so that webserver stability is guaranteed.
    [main.cpp]
2025-06-29 Reworked client data handling
    Changed to a different approach, data is now sent in between pauses and then stored locally. Still searching for a solution to better save data between reloads.
    [main.cpp]
2025-06-29 Website --> Websockets geupdated
    Bei den Websockets werden jetzt direkt die Daten für den Canvas gezeichnet.
2025-06-29 Improved client data saving
    There still persists the problem of a connection error when trying to reconnect to the AP after disconnecting
    [main.cpp]
